ExtraSlowCode/droneproject/README.md

# DroneProject

## What is this project?

Well, we were basically tasked to, in pairs, prototype and develop a sufficiently complex embedded system to show all that we had learned so far during our program. Me and my groupmate [@SamCodes200](https://github.com/SamCodes200) decided upon the simple task of achieving artificial flight in the form of our own drone, built from zero. While we did encounter a lot of hurdles along the way, we did technically achieve our goal of reaching a net positive thrust to weight ratio. This meant the drone did in fact lift off from the ground.

### What is in this repo?

The project wasn't executed in the most organized fashion, so this is primarily a publication of our results for later reference to myself or other interested parties. I humbly ask forgiveness for the unorganized files, they bother me too.

## Table of Contents and Links

|What/Where|What is it?|
|---|---|
|[Drone takeoff.mp4](doc/Drone%20takeoff.mp4)|Video proof showing the result of our work.|
|[Project report](doc/Project_in_embedded_systems_drone_development.pdf)|A long-form report describing the whole project. Seriously, if you're interested in the project; at least skim through it.|
|[Appendix A](doc/Project_in_embedded_systems_drone_development.pdf)|The most up-to-date version of our code.|
|[Component list](doc/components.md)|The list of components used.|
|[Component spreads](img/)|I tend to like visuals. The first and last stable prototypes.|
|[Progress reports](doc/test_reports)|Documentation showcasing us reaching our progress milestones, and documenting our problem solutions.|
|[Older code state](src/tests/drv8833_test.py)|An older version of the main file, I'll just call it untested for now.|

And not to flex, but I did all the chassis designs myself, lol. We went through a few of them.
