ExtraSlowCode/droneproject/doc/time_log.md

# Time Log

|Who?|What?|When?|
|----|-----|-----|
|**Up until 29/1:**|||
|Noa & Samuel|Mails to companies|2h|
|Noa|Repo setup|1,5h|
|Samuel|Research & Design|4h|
|Noa|Test 1|2h|
|**After timelog creation**|||
|Noa|Time log creation + sent.md added in repo|29/1, 11.00-12.10|
|Samuel|Research part list + control physics|29/1, 11.00-12.10|
|Noa & Samuel|Research, maths and milestone 1 work|29/1, 13.10-17.42|
|Noa|Writing milestone 1 report|16.40-17.30|
|Noa|Writing components list + purchase doc|13.15-13.50|
|Samuel|Experimentation with IMU(MPU1650)|13.15-13.50|
|Noa & Samuel|CAD chassis prototype 1|13.50-16.35|
|Samuel|Motor driver experimentation, Chassi print|13-16.35|
|Noa|Propeller testing, reports|5/2, 16.50-18.05|
|Samuel|component report|5/2, 17.20-18.05|
|Noa & Samuel|design new chassis, printer issues|6/2, 14.40-16.50|
|Noa & Samuel|printing of v1 chassis, design of v2 chassis, report of v1 chassis printing process|9/2, 12.15-14.20|
|Noa & Samuel|printing of v2 chassis, hardware soldering|9/2, 14.50-16.50|
|Noa & Samuel|presentations, chassi printing|10/2, 12.50-17.00|
|Noa|chassis v2.3 print, report writing|10/2, 17-18.10|
|Noa & Samuel|soldering on Beta prototype, test code draft|11/2, 14.30-16.40|
|Noa & Samuel|Finish Beta prototype, soldering and test|12/2, 11.00-15.30|
|Noa & Samuel|Chassis prototype design gamma|12/2, 16.30-17.00|
|Noa|finish gamma prototype chassis, documentation|12/2, 17.00-18.00|
|Noa|print gamma chassis, slicing|13/2, 10min total?|
|Noa & Samuel|component research, propellers, esc & motors for thesis|16/2, 21.30-00.00|
|Noa|component weighing and chart work|17/2, 12.45-14.40|
|Noa|solder gamma prototype, test|19/2, 11.50-12.30 + 12.30-18.50|
|Samuel|Presentation transcribing|19/2, 19.50-21.10|
|Noa & Samuel|midterm presentation writing and preperation|21/2, 15:50-17:30|
