ExtraSlowCode/droneproject/doc/funding_purchase_history.md

# Funding and Purchase history

## Funding Sources

Received the Linnaeus Union Literature Stipend in November 2025 of **500 SEK**

## Purchases

|Item|Amount|Price/st|Price Tot|Buy link|
|----|---|---|---|---|
|DC-motor|5 pcs|39,00 SEK|-195,00 SEK|<https://www.electrokit.com/dc-motor-3.7v-50000rpm-med-flaktblad>|
|-reimbursed|5 pcs|-|+195,00 SEK||
|DRV8833|6 pcs|12,48 SEK|- 74,87 SEK|<https://www.amazon.se/dp/B0DHRFRG6X?ref_=pe_111951831_1111173731_t_fed_asin_title>|
|DRV8833|6 pcs|||
|DC-motor|4 pcs|2,30 SEK|9,20 SEK||
