ExtraSlowCode/droneproject/doc/chassi_revisions/Alpha v1_3 body.stl

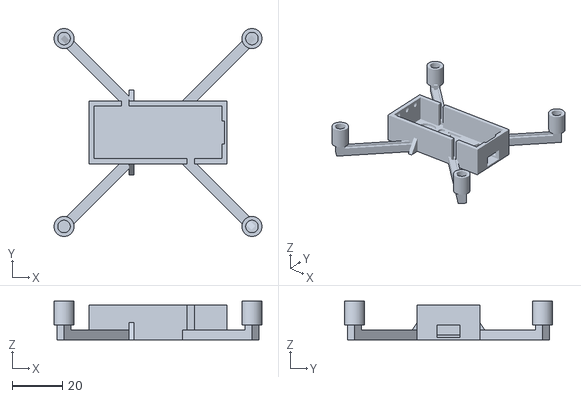
[picture p28: CAD file, 2026-10-23]
doc/chassi_revisions/Alpha v1_3 body.stl
83.0 x 83.0 x 15.5
