ExtraSlowCode/droneproject/doc/chassi_revisions/Beta v2_2 lid.stl

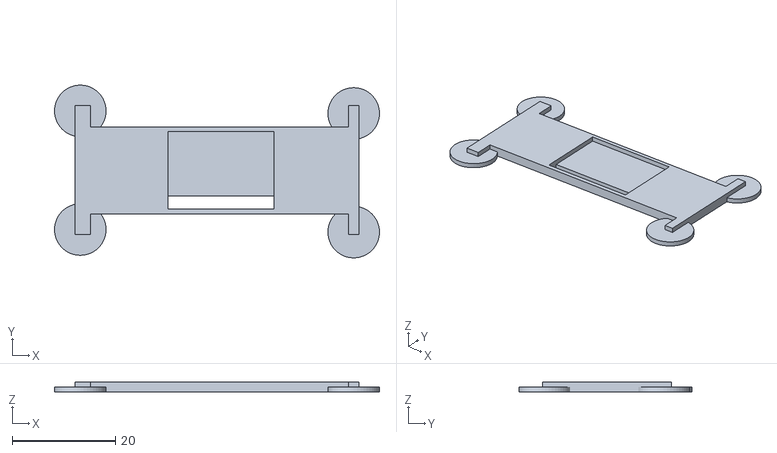
[picture p29: CAD file, 2026-10-23]
doc/chassi_revisions/Beta v2_2 lid.stl
63.0 x 33.5 x 2.00
