ExtraSlowCode/droneproject/doc/chassi_revisions/Beta v2_1 bat_cage.stl

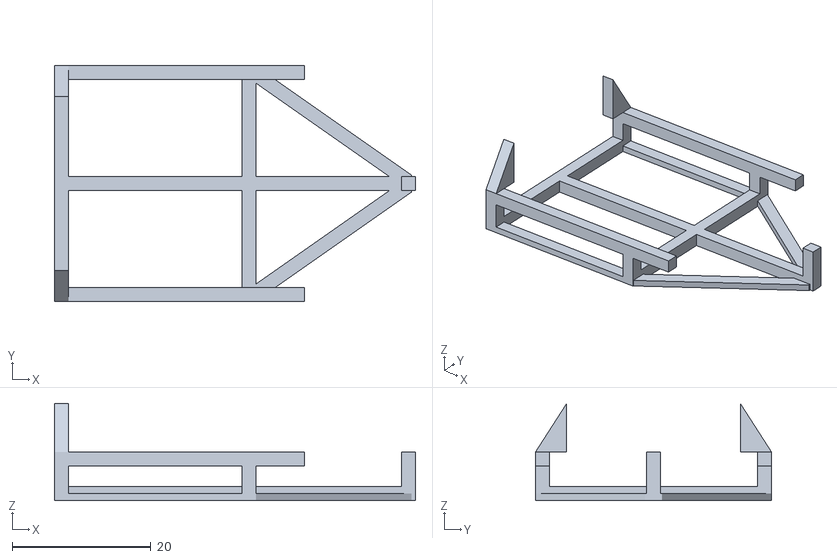
[picture p30: CAD file, 2026-10-23]
doc/chassi_revisions/Beta v2_1 bat_cage.stl
52.0 x 34.0 x 14.0
