ExtraSlowCode/droneproject/doc/chassi_revisions/Beta v2_3 body.stl

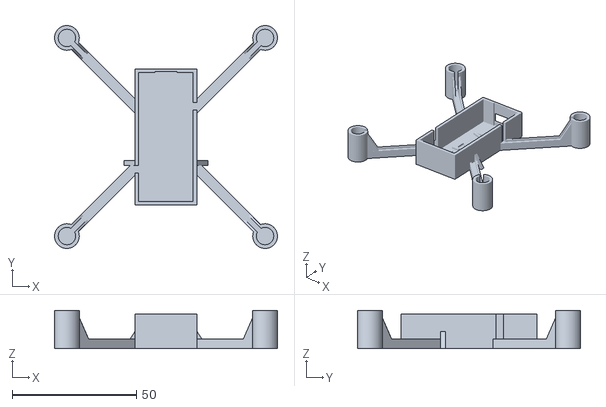
[picture p31: CAD file, 2026-10-23]
doc/chassi_revisions/Beta v2_3 body.stl
89.9 x 89.9 x 15.5
