ExtraSlowCode/droneproject/doc/chassi_revisions/Alpha v1_3.stl

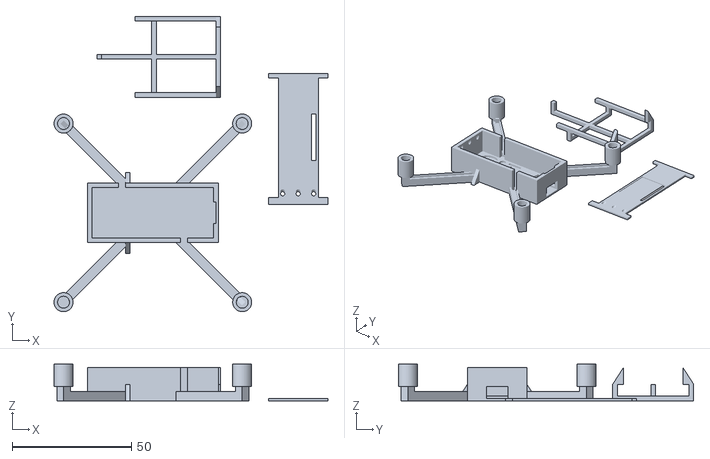
[picture p32: CAD file, 2026-10-23]
doc/chassi_revisions/Alpha v1_3.stl
115.0 x 124.0 x 15.5
