ExtraSlowCode/droneproject/doc/chassi_revisions/Alpha v1_3 lid.stl

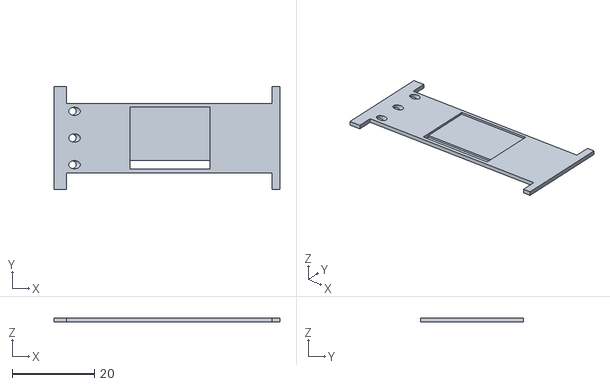
[picture p33: CAD file, 2026-10-23]
doc/chassi_revisions/Alpha v1_3 lid.stl
55.0 x 25.0 x 1.00
