ExtraSlowCode/droneproject/doc/chassi_revisions/Alpha v1_3 bat_cage.stl

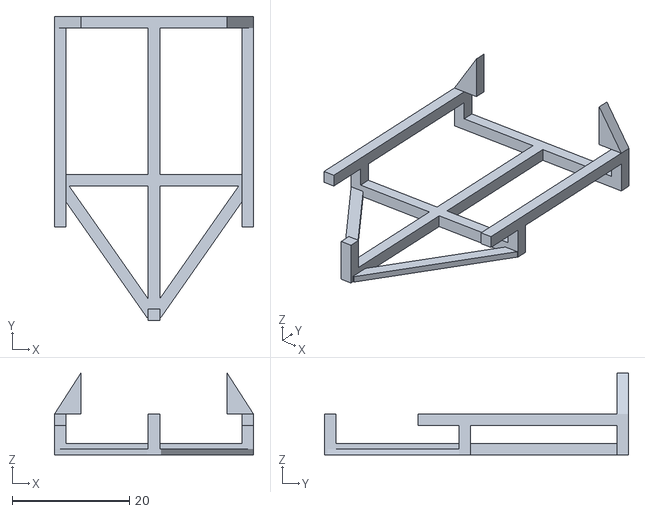
[picture p34: CAD file, 2026-10-23]
doc/chassi_revisions/Alpha v1_3 bat_cage.stl
34.0 x 52.0 x 14.0
