ExtraSlowCode/droneproject/doc/chassi_revisions/Gamma v3_1 body.stl

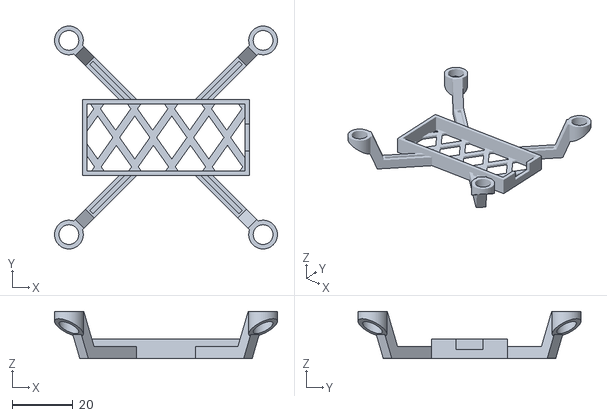
[picture p35: CAD file, 2026-10-23]
doc/chassi_revisions/Gamma v3_1 body.stl
73.5 x 73.5 x 15.5
