ExtraSlowCode/droneproject/doc/chassi_revisions/Beta v2_1 lid.stl

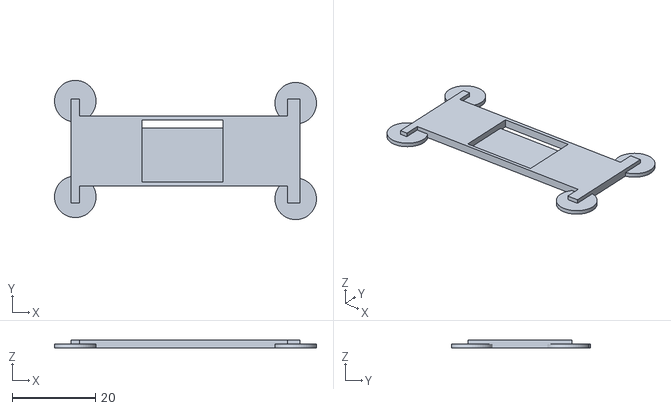
[picture p36: CAD file, 2026-10-23, an earlier design]
doc/chassi_revisions/Beta v2_1 lid.stl
63.0 x 33.5 x 2.00
