ExtraSlowCode/droneproject/doc/chassi_revisions/Alpha v1_1.stl

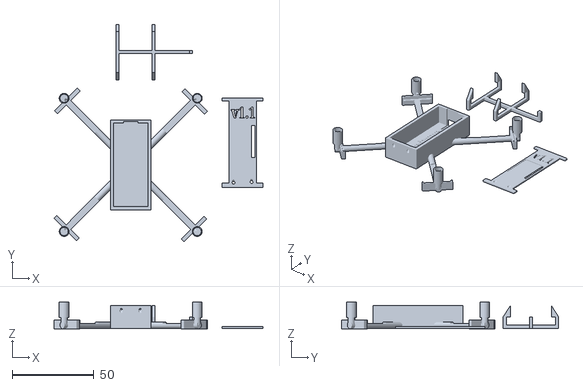
[picture p37: CAD file, 2026-10-23, an earlier design]
doc/chassi_revisions/Alpha v1_1.stl
127.9 x 133.0 x 16.3
