ExtraSlowCode/droneproject/doc/chassi_revisions/Alpha v1_2.stl

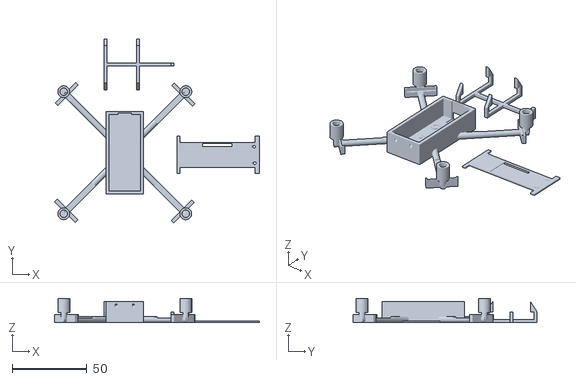
[picture p38: CAD file, 2026-10-23, an earlier design]
doc/chassi_revisions/Alpha v1_2.stl
136.9 x 123.0 x 16.3
