ExtraSlowCode/droneproject/doc/chassi_revisions/Beta v2_1 body.stl

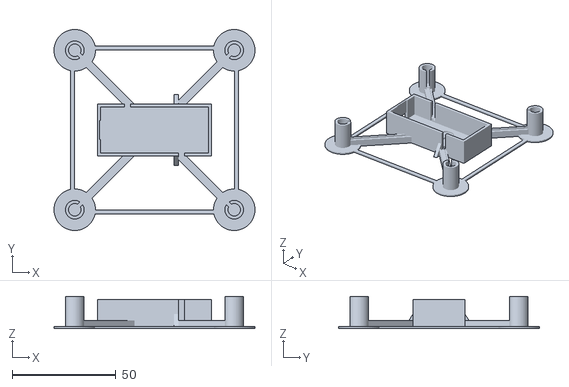
[picture p39: CAD file, 2026-10-23, an earlier design]
doc/chassi_revisions/Beta v2_1 body.stl
96.7 x 96.7 x 15.5
