ExtraSlowCode/droneproject/doc/test_reports/test1_19jan2026.md

# Experiment 1.1

Using code and breadboard layout reused from Samuel's a3 in Reliability in ES, we got a motor up and running.

[Test code](https://gitlab.lnu.se/nc222iw/droneproject/-/tree/ef9c818b849f3b65102d6f84a61765c75ae1e793/src/tests/test1)

Result: This simple segment from previous assignments can successfully control a DC motor from a RPI Pico.

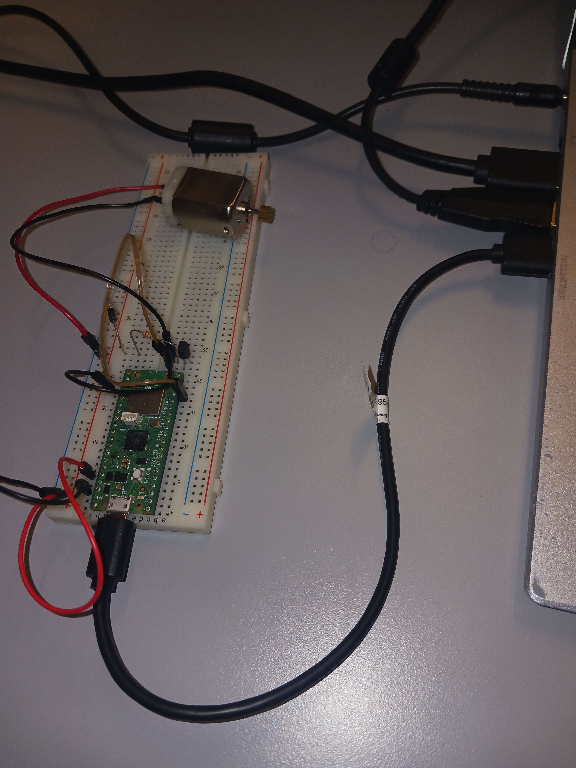
[picture p45: doc/test_reports/img/test1_img1.jpg]
test 1 board

Overview of board state

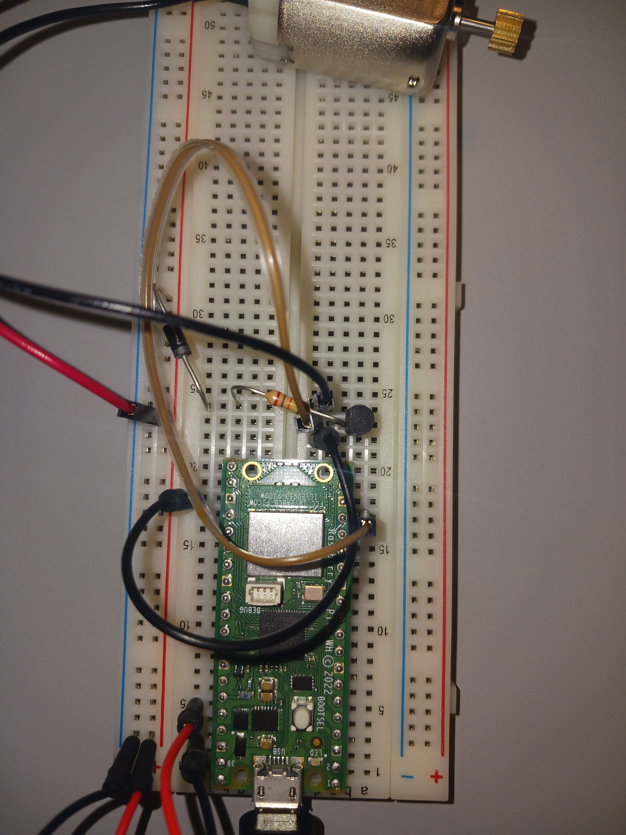
[picture p46: doc/test_reports/img/test1_img2.jpg]
test 1 wiring

Overview of board wiring during test 1

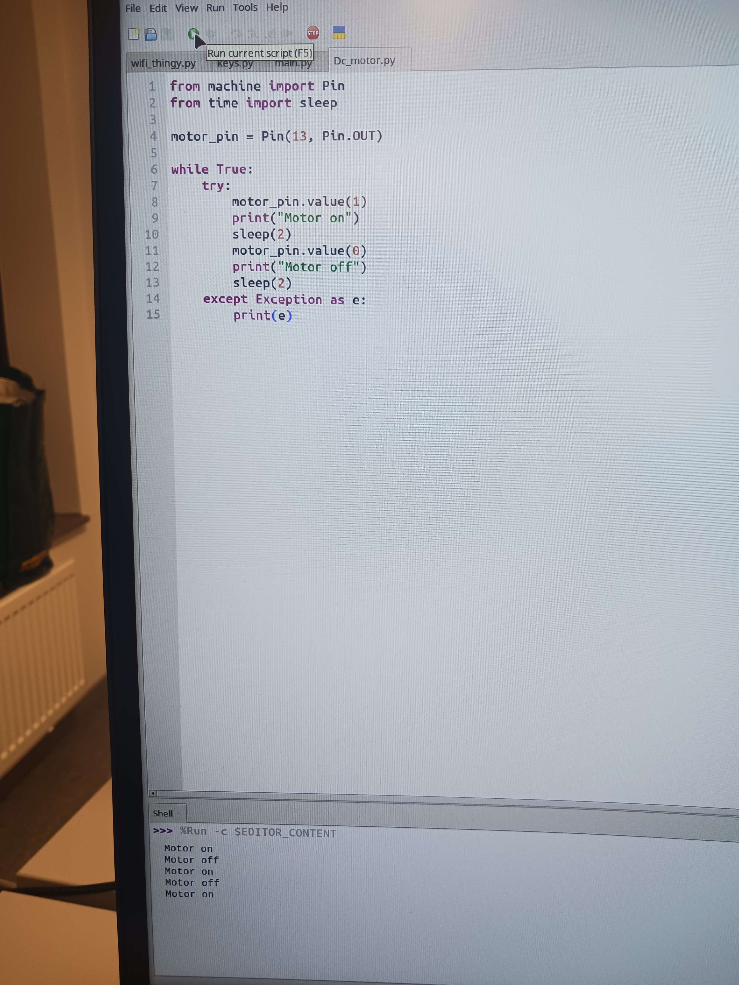
[picture p47: doc/test_reports/img/test1_img3.jpg]
test 1 code

Simple code for testing during test 1
