ExtraSlowCode/droneproject/doc/test_reports/test2_3feb2026.md

# Experiment 2.1

[https://github.com/TimHanewich/MicroPython-Collection/tree/master/MPU6050](https://github.com/TimHanewich/MicroPython-Collection/tree/master/MPU6050)

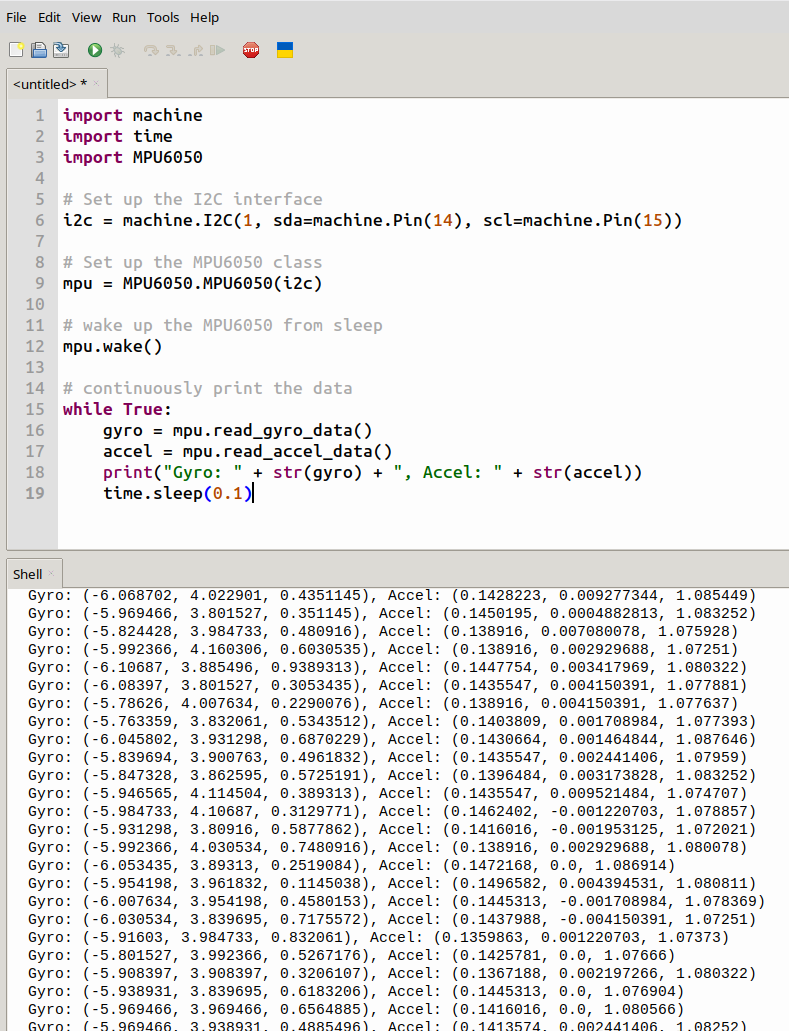
[picture p48: doc/test_reports/img/test2_img1.png]
code for test 2


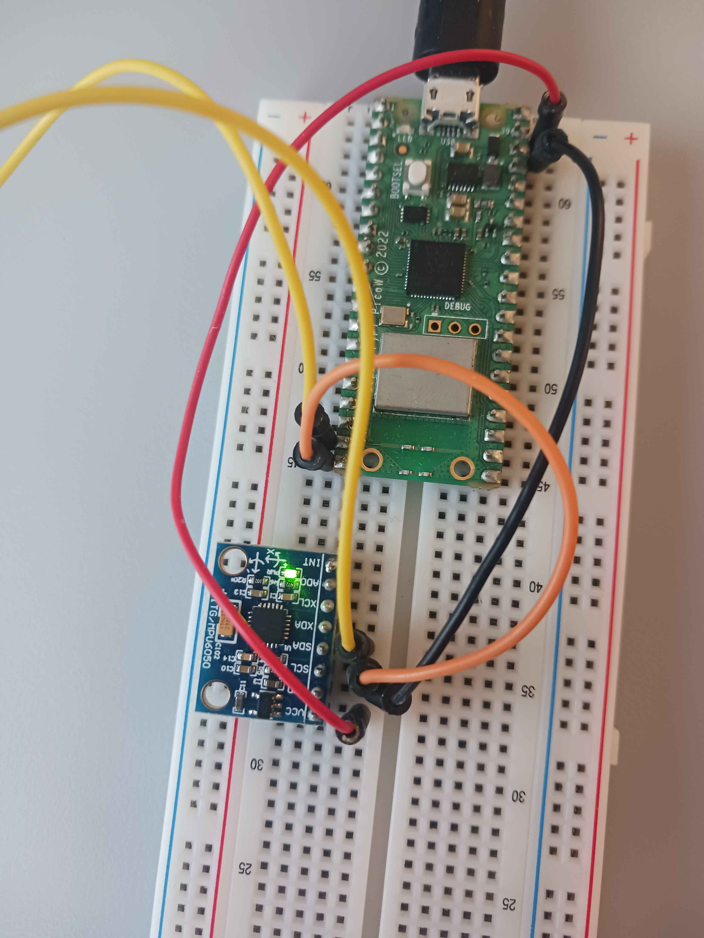
[picture p49: doc/test_reports/img/test2_img2.png]
board for test 2
