ExtraSlowCode/droneproject/src/tests/drone_physics/PIDBalancing.png

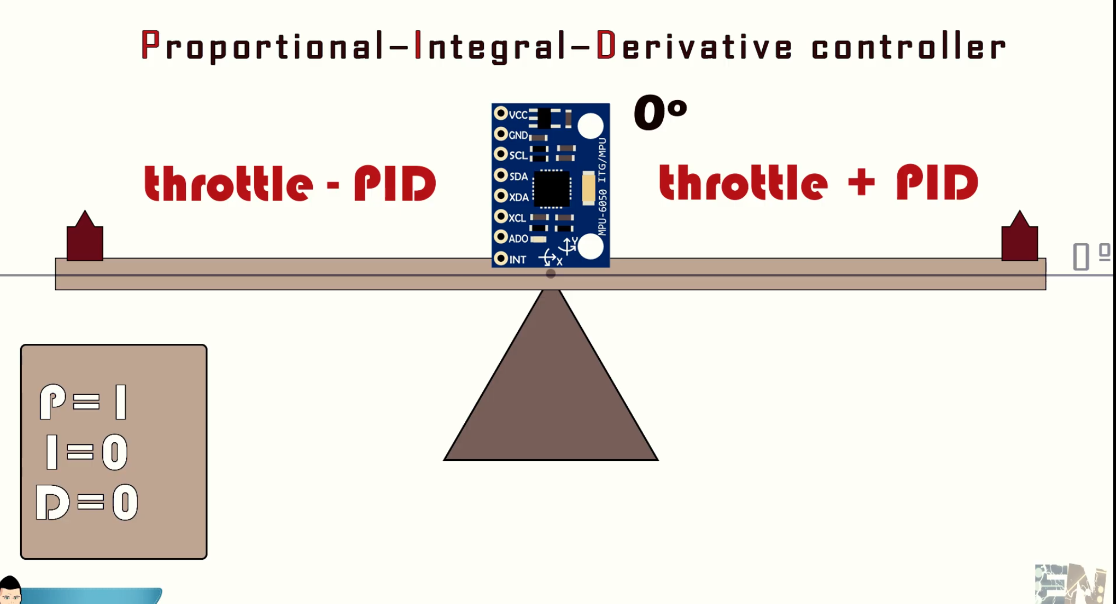
src/tests/drone_physics/PIDBalancing.png
