ExtraSlowCode/droneproject/src/tests/drone_physics/pitch.png

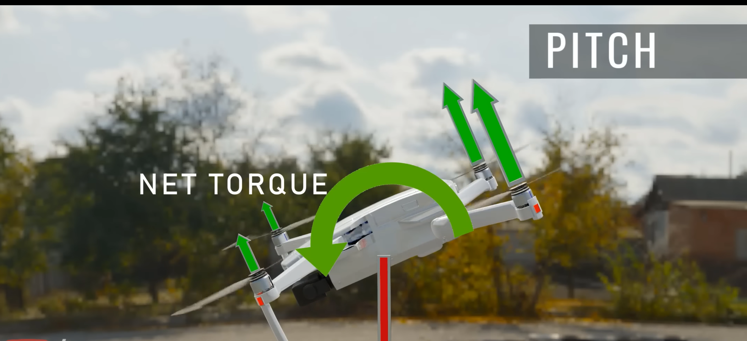
src/tests/drone_physics/pitch.png
