ExtraSlowCode/droneproject/src/tests/drone_physics/yaw.png

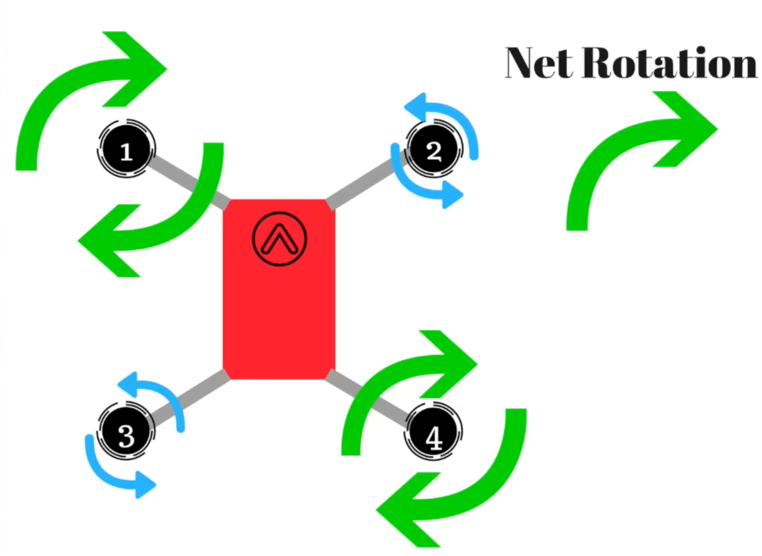
src/tests/drone_physics/yaw.png
