ExtraSlowCode/droneproject/src/tests/Gyro_acc.py

import machine
import time
import MPU6050 # ../lib/MPU6050.py

# Set up the I2C interface
i2c = machine.I2C(1, sda=machine.Pin(14), scl=machine.Pin(15))

# Set up the MPU6050 class 
mpu = MPU6050.MPU6050(i2c)


# wake up the MPU6050 from sleep
mpu.wake()

# continuously print the data
while True:
    gyro = mpu.read_gyro_data()
    accel = mpu.read_accel_data()
    print("Gyro: " + str(gyro) + ", Accel: " + str(accel))
    time.sleep(0.1)
