ExtraSlowCode/droneproject/doc/test_reports/img/test3_img1.png

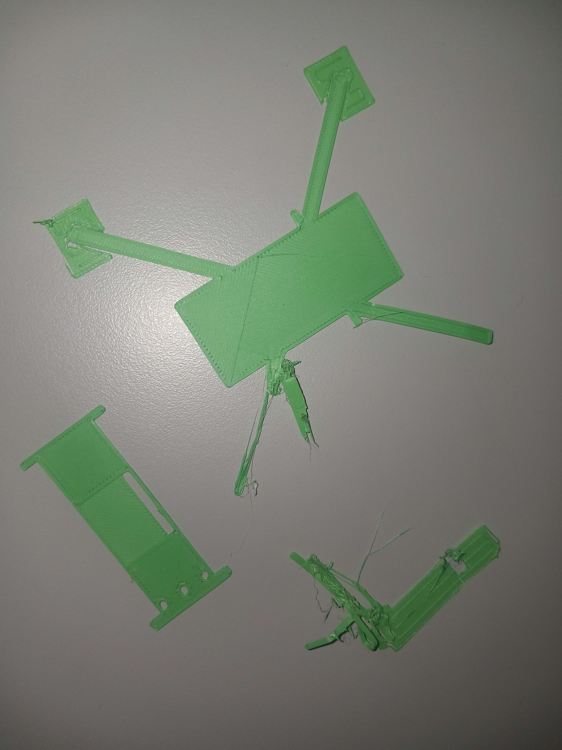
[picture p51: doc/test_reports/img/test3_img1.png]
doc/test_reports/img/test3_img1.png
